rastermanden/openCycloComputer/hardware/README.md

# Hardware

Dokumentationen bor i [../docs/hardware.md](../docs/hardware.md) og [../docs/bom.md](../docs/bom.md).

Denne mappe er til det der ikke er prosa: datablade vi må gemme en kopi af, måleskitser, og senere KiCad-projektet hvis prototypen flytter fra Feather-breakout til et eget kort. Læg ikke andres ophavsretligt beskyttede PDF'er her, medmindre licensen tillader det. Et link i `docs/` er nok.

Mekanikken, inklusive mål på printene som kabinettet er tegnet efter, står i [../enclosure/README.md](../enclosure/README.md).
