rastermanden/openCycloComputer/enclosure/freecad/openCycloComputer_enclosure.FCStd

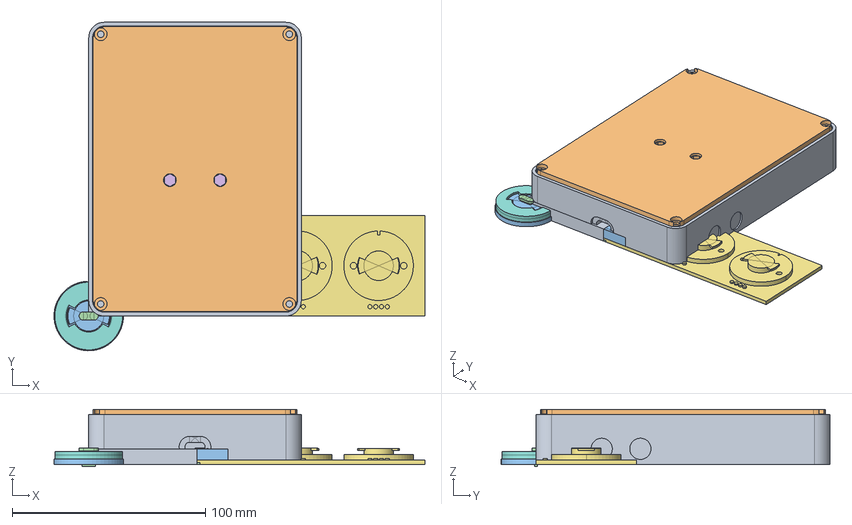
[picture p1: CAD file, 2026-10-31]
enclosure/freecad/openCycloComputer_enclosure.FCStd
192.0 x 170.0 x 29.6 mm
CaseBody
CaseLid
GarminMount
UsbPlug
BaroHood
FitTestFrame
ToleranceCoupon
GarminGauge
GasketCouponBody
GasketCouponLid
InsertTestStrip
WindowSheet
