rastermanden/openCycloComputer/enclosure/step/garmin_gauge_socket.step

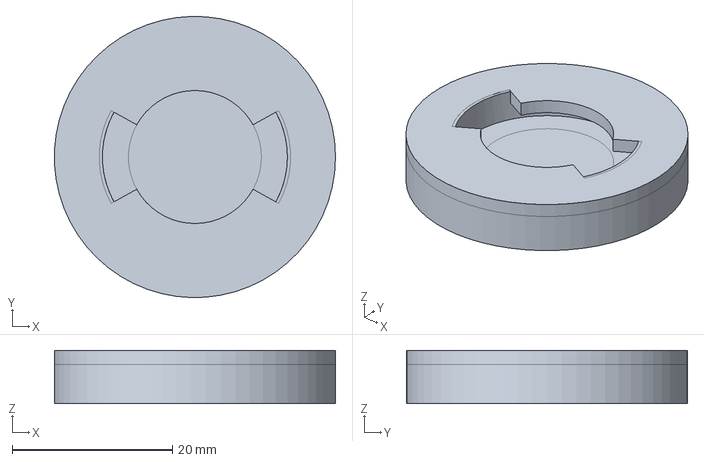
[picture p2: CAD file, 2026-10-31]
enclosure/step/garmin_gauge_socket.step
35.1 x 35.1 x 6.62 mm
