rastermanden/openCycloComputer/enclosure/step/case_lid.step

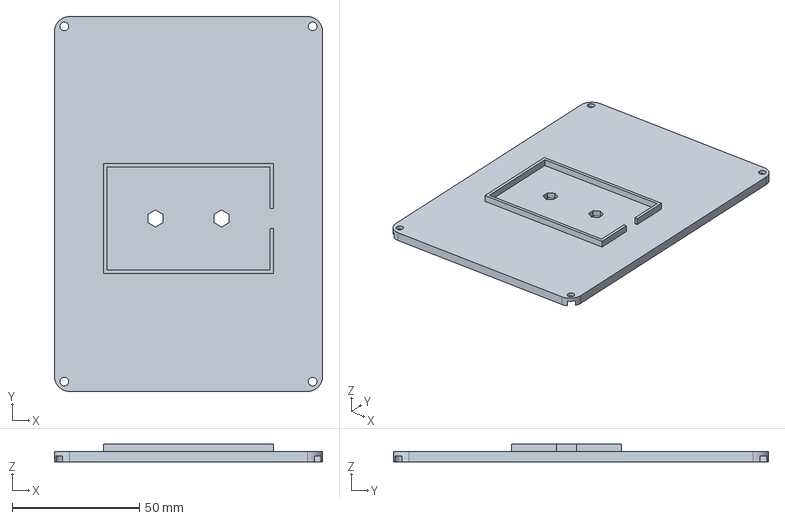
[picture p3: CAD file, 2026-10-31]
enclosure/step/case_lid.step
105.4 x 147.4 x 7.00 mm
