rastermanden/openCycloComputer/enclosure/step/usb_c_plug.step

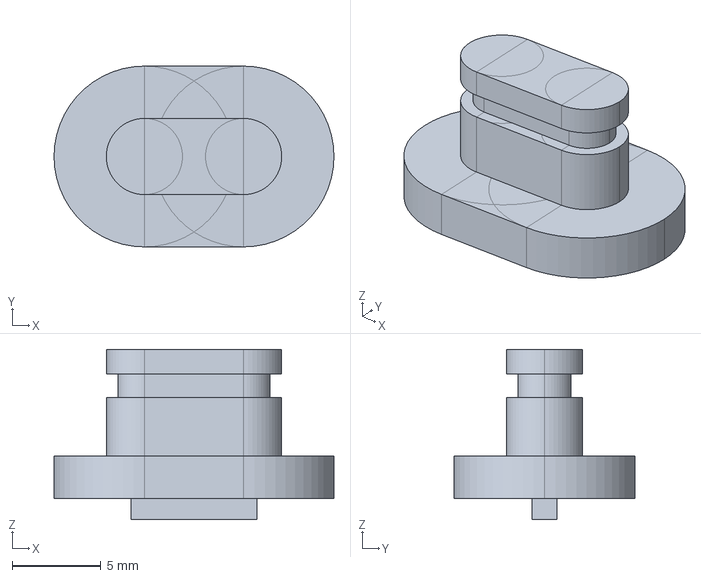
[picture p4: CAD file, 2026-10-31]
enclosure/step/usb_c_plug.step
15.8 x 10.2 x 9.60 mm
