rastermanden/openCycloComputer/enclosure/step/insert_test_strip.step

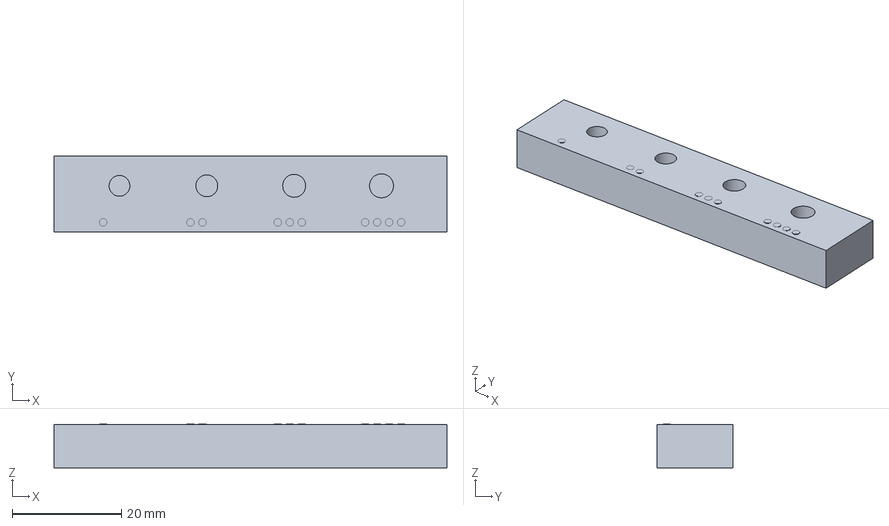
[picture p5: CAD file, 2026-10-31]
enclosure/step/insert_test_strip.step
72.0 x 14.0 x 8.05 mm
