rastermanden/openCycloComputer/enclosure/step/garmin_mount.step

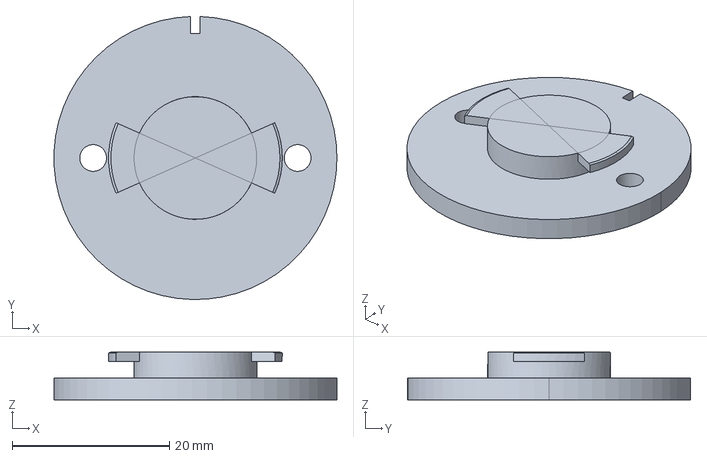
[picture p6: CAD file, 2026-10-31]
enclosure/step/garmin_mount.step
36.0 x 36.0 x 6.10 mm
