rastermanden/openCycloComputer/enclosure/step/case_body.step

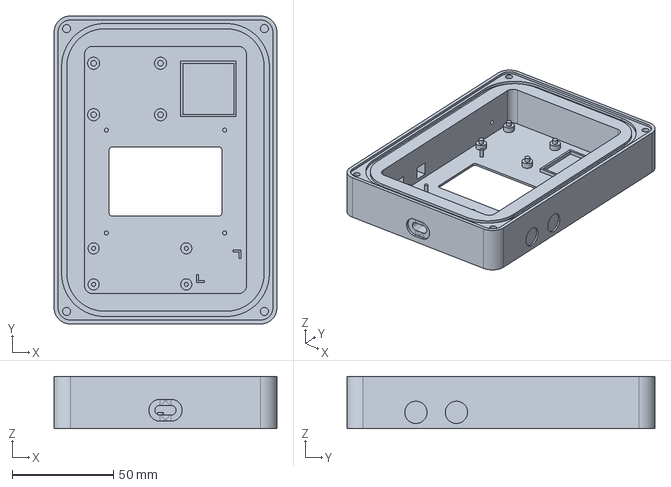
[picture p7: CAD file, 2026-10-31]
enclosure/step/case_body.step
110.0 x 152.0 x 25.7 mm
