rastermanden/openCycloComputer/enclosure/step/tolerance_coupon.step

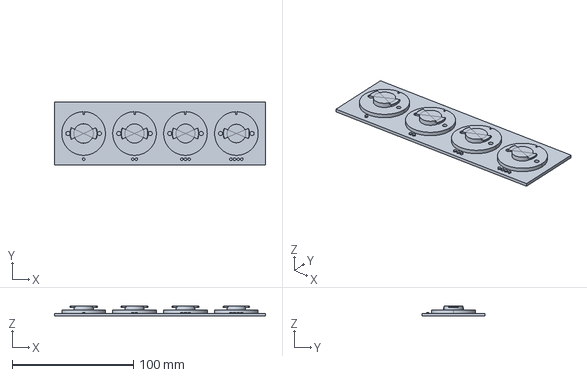
[picture p8: CAD file, 2026-10-31]
enclosure/step/tolerance_coupon.step
174.0 x 52.0 x 8.45 mm
