rastermanden/openCycloComputer/enclosure/step/gasket_coupon_body.step

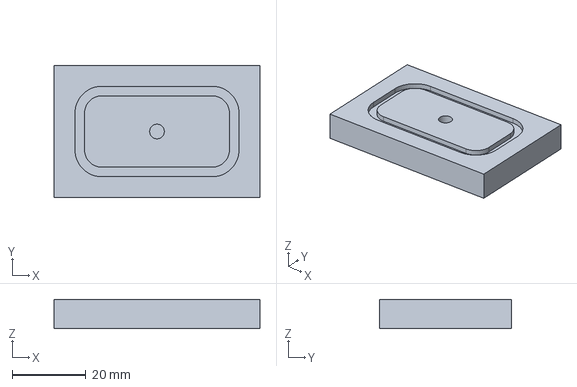
[picture p9: CAD file, 2026-10-31]
enclosure/step/gasket_coupon_body.step
56.0 x 36.0 x 8.00 mm
