rastermanden/openCycloComputer/enclosure/step/window_sheet_blank.step

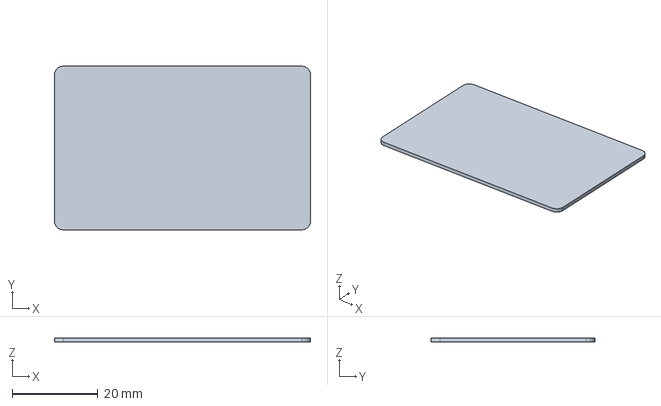
[picture p10: CAD file, 2026-10-31]
enclosure/step/window_sheet_blank.step
59.6 x 38.1 x 1.00 mm
