rastermanden/openCycloComputer/enclosure/step/baro_hood.step

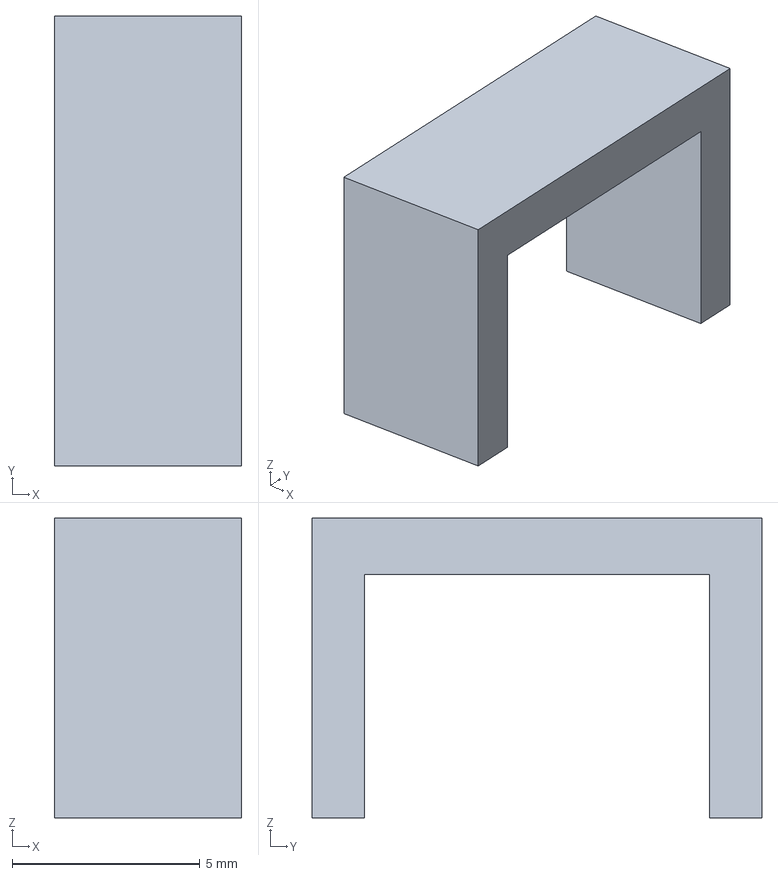
[picture p11: CAD file, 2026-10-31]
enclosure/step/baro_hood.step
5.00 x 12.0 x 8.00 mm
