rastermanden/openCycloComputer/enclosure/step/fit_test_frame.step

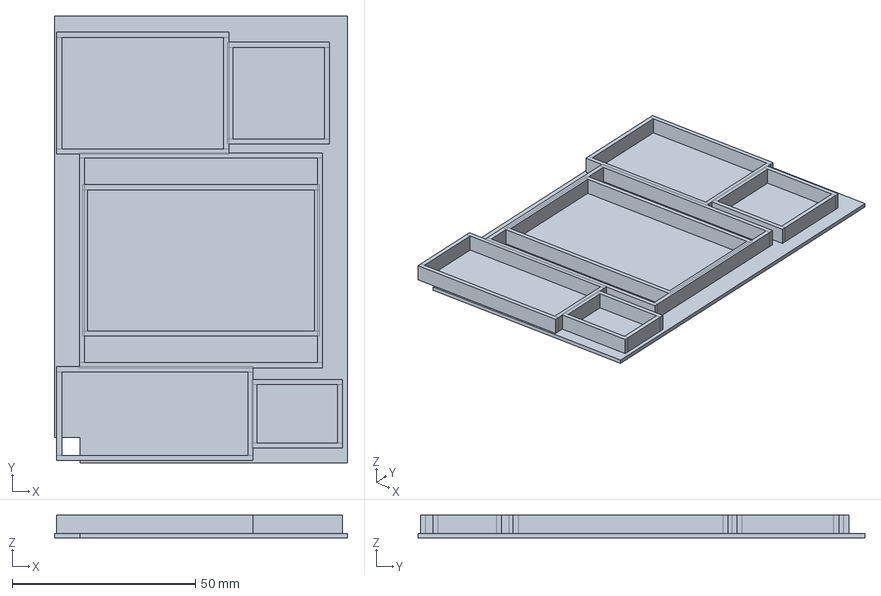
[picture p12: CAD file, 2026-10-31]
enclosure/step/fit_test_frame.step
80.0 x 122.0 x 6.20 mm
