rastermanden/openCycloComputer/enclosure/step/gasket_coupon_lid.step

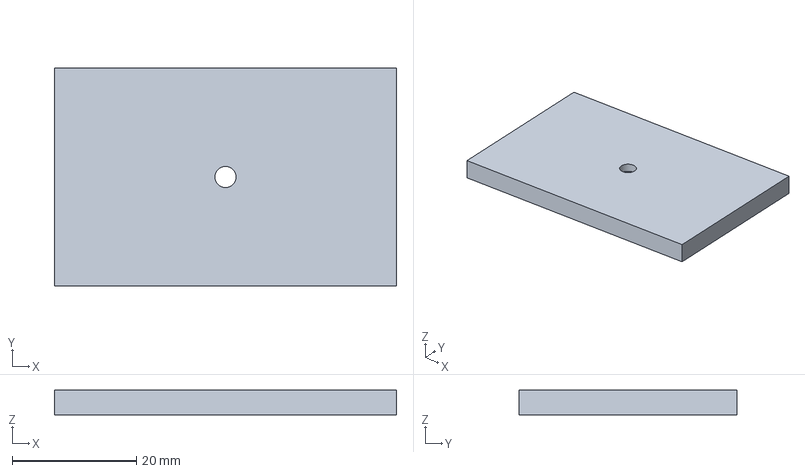
[picture p13: CAD file, 2026-10-31]
enclosure/step/gasket_coupon_lid.step
55.0 x 35.0 x 4.00 mm
