rastermanden/openCycloComputer/(list of files, cad)

Other CAD files:
enclosure/stl/baro_hood.stl
enclosure/stl/case_body.stl
enclosure/stl/case_lid.stl
enclosure/stl/fit_test_frame.stl
enclosure/stl/garmin_gauge_socket.stl
enclosure/stl/garmin_mount.stl
enclosure/stl/gasket_coupon_body.stl
enclosure/stl/gasket_coupon_lid.stl
enclosure/stl/insert_test_strip.stl
enclosure/stl/tolerance_coupon.stl
enclosure/stl/usb_c_plug.stl
enclosure/stl/window_sheet_blank.stl
